msilanus/weightMesure/capteur-poids-50-kg-sfe_1.jpg

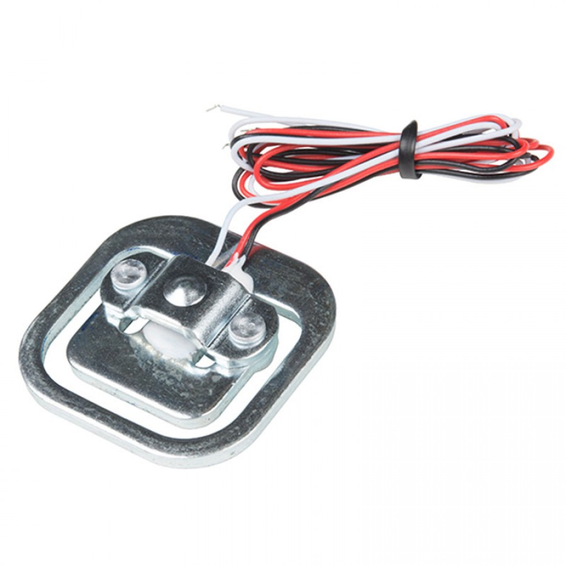
capteur-poids-50-kg-sfe_1.jpg
