msilanus/weightMesure/modele_pont.png

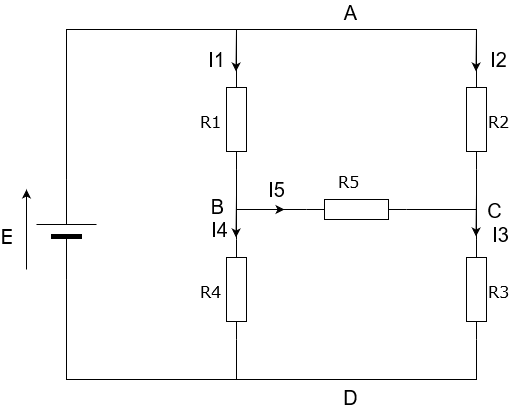
modele_pont.png
