msilanus/weightMesure/balanceAmpliRobotShop/balanceAmpliRobotShop.ino

/*
  AnalogReadSerial
  Reads an analog input on pin 0, prints the result to the serial monitor.
  Graphical representation is available using serial plotter (Tools > Serial Plotter menu)
  Attach the center pin of a potentiometer to pin A0, and the outside pins to +5V and ground.

  This example code is in the public domain.
*/

// the setup routine runs once when you press reset:
void setup() {
  // initialize serial communication at 9600 bits per second:
  Serial.begin(9600);
}

// the loop routine runs over and over again forever:
void loop() {
  // read the input on analog pin 0:
  int N = analogRead(A0);
  float masse;
  masse = 278.0*(float)N - 13066.0;
  //  print out the value you read:
  Serial.print(N);
  Serial.print(" | ");
  Serial.print(masse);
  Serial.println(" g");
  
  delay(1000);        // delay in between reads for stability
}
